pommen/Programmable_Load/README.md

# Programmable-Load

Programmable DC load 0-10 amps 0-40 volts
Based on STM32 "bluepill" mcu running STMduino core.

All schematics in KiĆAD
