pommen/Programmable_Load/HW/ControllerStage.kicad_pcb

## KiCad design HW/ControllerStage.kicad_pcb (2018-04-08)

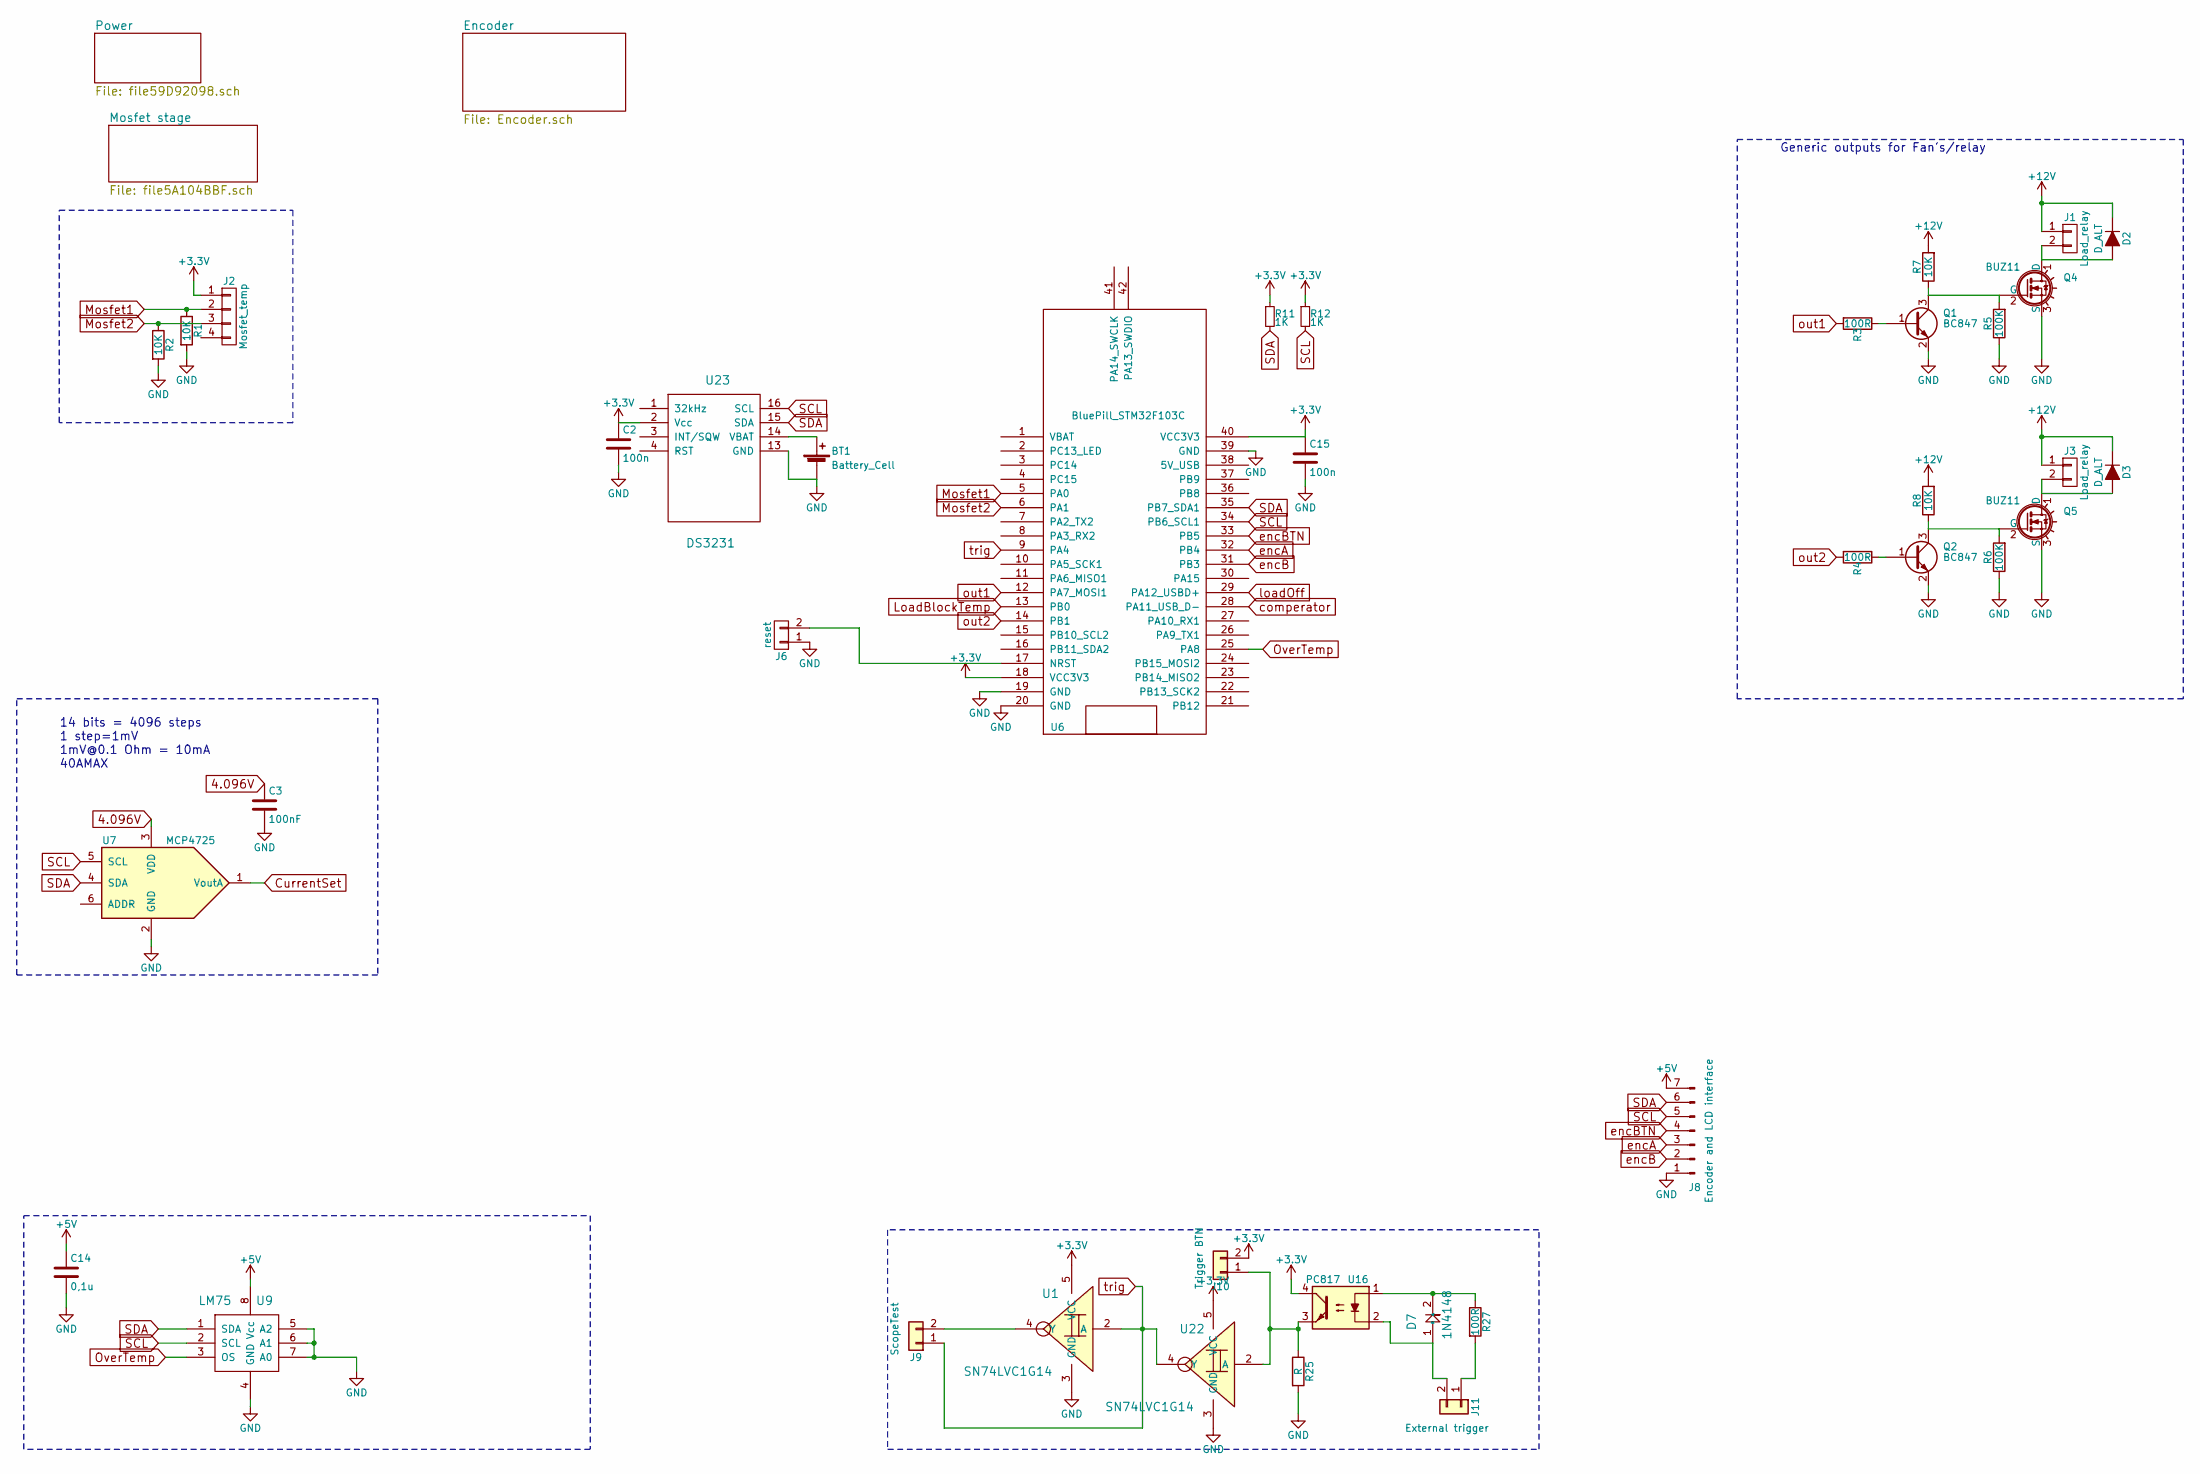
[picture p1: schematic ControllerStage.sch]

Parts:
BT1: Battery_Cell; Keystone_3008_1x2450-CoinCell
C2, C15: 100n; C_0805_HandSoldering
C3: 100nF; C_0805_HandSoldering
C14: 0,1u; C_0805_HandSoldering
D2, D3: D_ALT; D_MELF-RM10_Universal_Handsoldering
D7: 1N4148; D_DO-35_SOD27_P7.62mm_Horizontal
J1, J3: Load_relay; Socket_Strip_Straight_1x02_Pitch2.54mm
J2: Mosfet_temp; Socket_Strip_Straight_1x04_Pitch2.54mm
J6: reset; Pin_Header_Straight_1x02_Pitch2.54mm
J8: Encoder and LCD interface; Pin_Header_Straight_1x07_Pitch2.54mm
J9: ScopeTest; JUMPER_5MM
J10: Trigger BTN; JUMPER_5MM
J11: External trigger; JUMPER_5MM
Q1, Q2: BC847; SOT-23_Handsoldering
Q4, Q5: BUZ11; TO-220-3_Vertical
R1, R2, R7, R8: 10K; R_0805_HandSoldering
R3, R4, R27: 100R; R_0805_HandSoldering
R5, R6: 100K; R_0805_HandSoldering
R11, R12: 1K; R_0805_HandSoldering
R25: R; R_0805_HandSoldering
U1, U22: SN74LVC1G14; SOT-23-5_HandSoldering
U6: BluePill_STM32F103C
U7: MCP4725; TSOT-23-6_HandSoldering
U9: LM75; SO-8_5.3x6.2mm_Pitch1.27mm
U16: PC817; DIP-4_W7.62mm
U23: DS3231; SOIC-16W_7.5x10.3mm_Pitch1.27mm

Connections:
4.096V: C3.1, U7.3 (VDD); also elsewhere on the board
+3V3: C2.1, C15.1, J2.1, J10.2, R11.1, R12.1, U1.5 (VCC), U6.18 (VCC3V3), U6.40 (VCC3V3), U16.4, U22.5 (VCC), U23.2 (Vcc); also elsewhere on the board
+5V: C14.1, J8.7, U9.8 (Vcc); also elsewhere on the board
+12V: D2.1 (K), D3.1 (K), J1.1, J3.1, R7.2, R8.2; also elsewhere on the board
CurrentSet: U7.1 (VoutA); also elsewhere on the board
Earth: BT1.2 (-), C2.2, C3.2, C14.2, C15.2, J6.1, J8.1, Q1.2 (E), Q2.2 (E), Q4.3 (S), Q5.3 (S), R1.2, R2.2, R5.1, R6.1, R25.2, U1.3 (GND), U6.19 (GND), U6.20 (GND), U6.39 (GND), U7.2 (GND), U9.4 (GND), U9.5 (A2), U9.6 (A1), U9.7 (A0), U22.3 (GND), U23.11 (NC), U23.13 (GND); also elsewhere on the board
LoadBlockTemp: U6.13 (PB0); also elsewhere on the board
Mosfet1: J2.2, R1.1, U6.5 (PA0)
Mosfet2: J2.3, R2.1, U6.6 (PA1)
unnamed: BT1.1 (+), U23.14 (VBAT)
unnamed: D2.2 (A), J1.2, Q4.1 (D)
unnamed: D3.2 (A), J3.2, Q5.1 (D)
unnamed: D7.1 (A), J11.2, U16.2
unnamed: D7.2 (K), R27.1, U16.1
unnamed: J6.2, U6.17 (NRST)
unnamed: J9.2, U1.4 (Y)
unnamed: J10.1, R25.1, U16.3, U22.2 (A)
unnamed: J11.1, R27.2
unnamed: Q1.1 (B), R3.1
unnamed: Q1.3 (C), Q4.2 (G), R5.2, R7.1
unnamed: Q2.1 (B), R4.1
unnamed: Q2.3 (C), Q5.2 (G), R6.2, R8.1
OverTemp: U6.25 (PA8), U9.3 (OS)
SCL: J8.5, R12.2, U6.34 (PB6_SCL1), U7.5 (SCL), U9.2 (SCL), U23.16 (SCL); also elsewhere on the board
SDA: J8.6, R11.2, U6.35 (PB7_SDA1), U7.4 (SDA), U9.1 (SDA), U23.15 (SDA); also elsewhere on the board
comperator: U6.28 (PA11_USB_D-); also elsewhere on the board
encA: J8.3, U6.32 (PB4)
encB: J8.2, U6.31 (PB3)
encBTN: J8.4, U6.33 (PB5)
loadOff: U6.29 (PA12_USBD+); also elsewhere on the board
out1: R3.2, U6.12 (PA7_MOSI1)
out2: R4.2, U6.14 (PB1)
trig: J9.1, U1.2 (A), U6.9 (PA4), U22.4 (Y)

Notes on the sheet:
14 bits = 4096 steps 1 step=1mV 1mV@0.1 Ohm = 10mA 40AMAX
Generic outputs for Fan's/relay

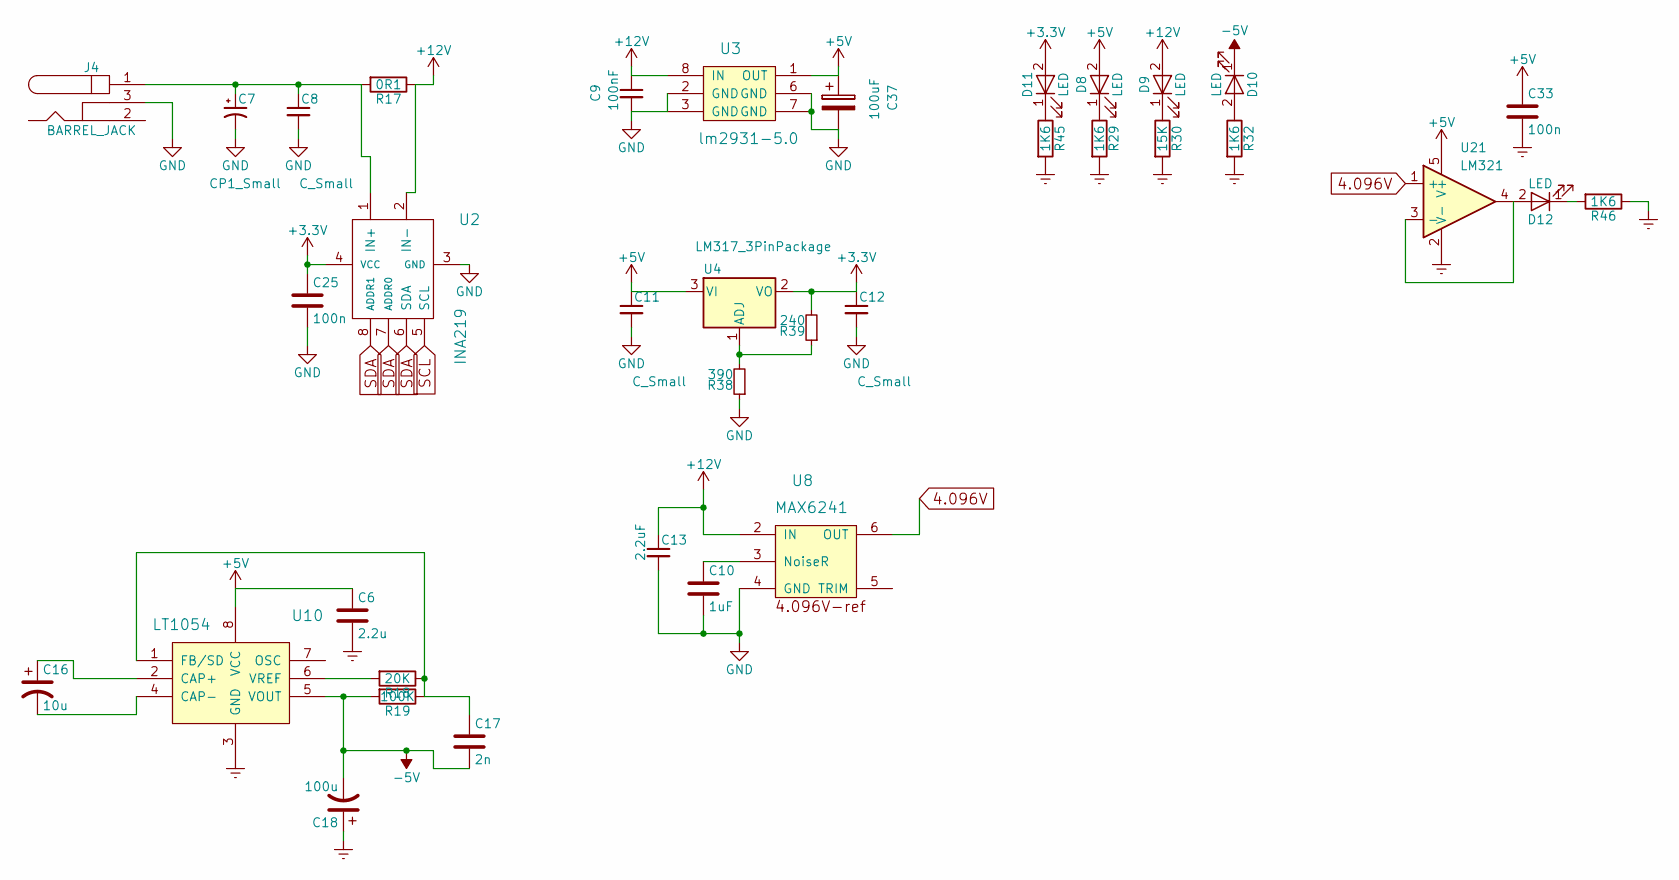
[picture p2: schematic file59D92098.sch]

Parts:
C6: 2.2u; C_0805_HandSoldering
C7: CP1_Small; CP_Tantalum_Case-C_EIA-6032-28_Hand
C8, C11, C12: C_Small; C_0805_HandSoldering
C9: 100nF; C_0805_HandSoldering
C10: 1uF; C_0805_HandSoldering
C13: 2.2uF; C_0805_HandSoldering
C16: 10u; CP_Tantalum_Case-B_EIA-3528-21_Hand
C17: 2n; C_0805_HandSoldering
C18: 100u; CP_Tantalum_Case-B_EIA-3528-21_Hand
C25, C33: 100n; C_0805_HandSoldering
C37: 100uF; CP_Radial_D6.3mm_P2.50mm
D8, D9, D10, D11, D12: LED; LED_0805_HandSoldering
J4: BARREL_JACK
R17: 0R1; R_1206_HandSoldering
R18: 20K; R_0805_HandSoldering
R19: 100K; R_0805_HandSoldering
R29, R32, R45, R46: 1K6; R_0805_HandSoldering
R30: 15K; R_0805_HandSoldering
R38: 390; R_0805_HandSoldering
R39: 240; R_0805_HandSoldering
U2: INA219; SOT-23-8_Handsoldering
U3: lm2931-5.0; SOIC-8_3.9x4.9mm_Pitch1.27mm
U4: LM317_3PinPackage; SOT-223-3_TabPin2
U8: MAX6241; SOIC-8_3.9x4.9mm_Pitch1.27mm
U10: LT1054; DIP-8_W7.62mm_LongPads
U21: LM321; SOT-23-5_HandSoldering

Connections:
4.096V: U8.6 (OUT), U21.1 (+); also elsewhere on the board
+3V3: C12.1, C25.1, D11.2 (A), R39.2, U2.4 (VCC), U4.2 (VO); also elsewhere on the board
+5V: C6.1, C11.1, C33.1, C37.1, D8.2 (A), U3.1 (OUT), U4.3 (VI), U10.8 (VCC), U21.5 (V+); also elsewhere on the board
+12V: C9.1, C13.1, D9.2 (A), R17.1, U2.2 (IN-), U3.8 (IN), U8.2 (IN); also elsewhere on the board
-5V: C17.2, C18.2, D10.1 (K), R19.2, U10.5 (VOUT); also elsewhere on the board
Earth: C6.2, C7.2, C8.2, C9.2, C10.2, C11.2, C12.2, C13.2, C18.1, C25.2, C33.2, C37.2, J4.3, R29.2, R30.2, R32.2, R38.1, R45.2, R46.1, U2.3 (GND), U3.2 (GND), U3.3 (GND), U3.6 (GND), U3.7 (GND), U8.4 (GND), U10.3 (GND), U21.2 (V-); also elsewhere on the board
unnamed: C7.1, C8.1, J4.1, R17.2, U2.1 (IN+)
unnamed: C10.1, U8.3 (NoiseR)
unnamed: C16.1, U10.2 (CAP+)
unnamed: C16.2, U10.4 (CAP-)
unnamed: C17.1, R18.1, R19.1, U10.1 (FB/SD)
unnamed: D8.1 (K), R29.1
unnamed: D9.1 (K), R30.1
unnamed: D10.2 (A), R32.1
unnamed: D11.1 (K), R45.1
unnamed: D12.1 (K), R46.2
unnamed: D12.2 (A), U21.3 (-), U21.4
unnamed: R18.2, U10.6 (VREF)
unnamed: R38.2, R39.1, U4.1 (ADJ)
SCL: U2.5 (SCL); also elsewhere on the board
SDA: U2.6 (SDA), U2.7 (ADDR0), U2.8 (ADDR1); also elsewhere on the board

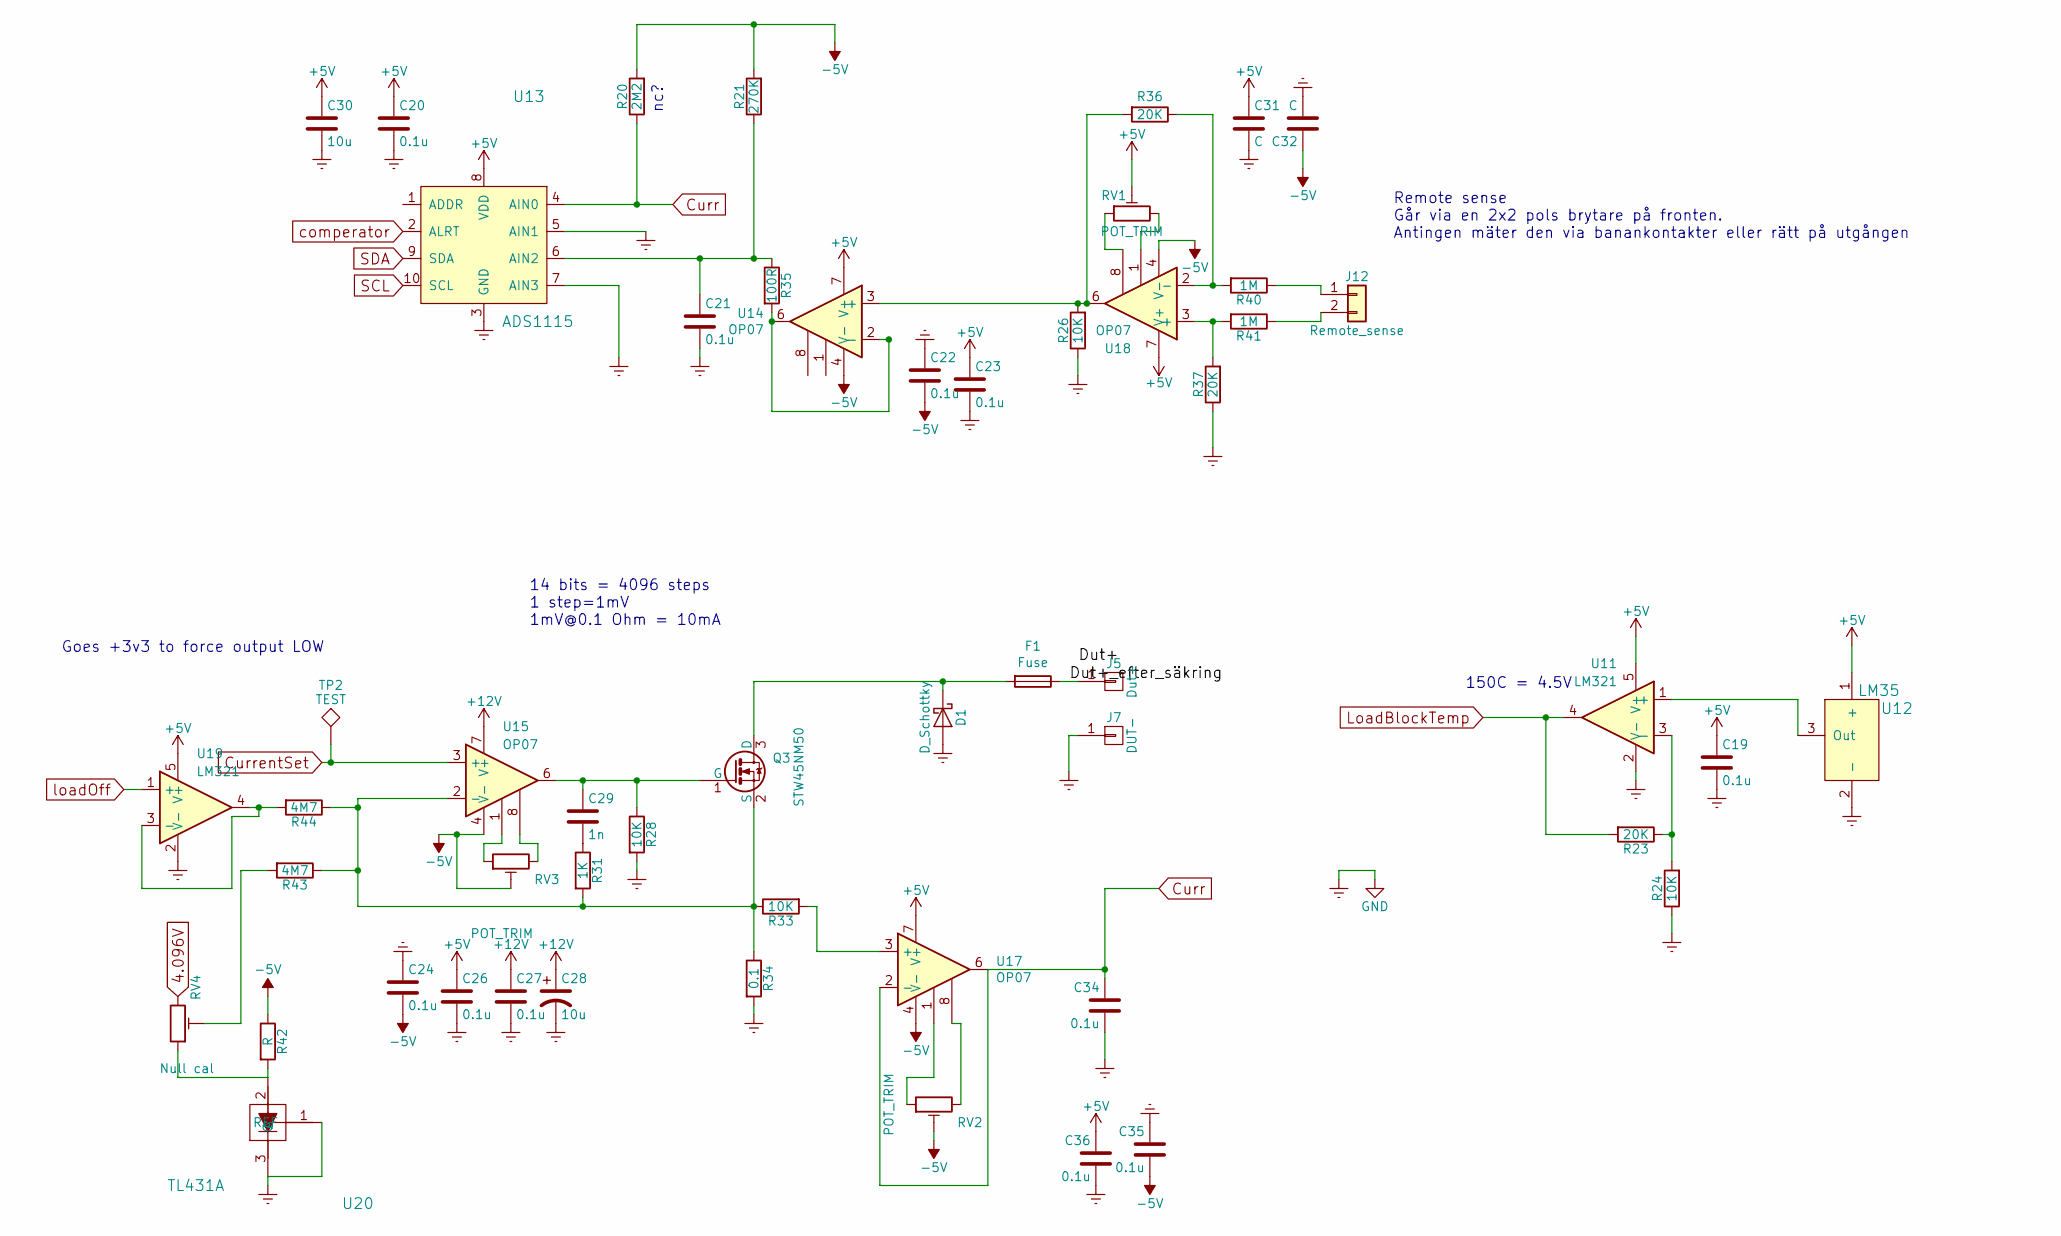
[picture p3: schematic file5A104BBF.sch, Programmable Load Mosfet stage]

Parts:
C19, C20, C21, C22, C23, C24, C26, C27, C34, C35, C36: 0.1u; C_0805_HandSoldering
C28: 10u; CP_Tantalum_Case-B_EIA-3528-21_Hand
C29: 1n; C_0805_HandSoldering
C30: 10u; C_0805_HandSoldering
C31, C32: C; C_0805_HandSoldering
D1: D_Schottky; D_SMB-SMC_Universal_Handsoldering
F1: Fuse; Fuseholder5x20_horiz_open_universal_Type-III
J5: Dut+; MountingHole_3.2mm_M3
J7: DUT-; MountingHole_3.2mm_M3
J12: Remote_sense; JUMPER_5MM
Q3: STW45NM50; TO-247_TO-3P_Vertical
R20: 2M2; R_0805_HandSoldering
R21: 270K; R_0805_HandSoldering
R23, R36, R37: 20K; R_0805_HandSoldering
R24, R26, R28, R33: 10K; R_0805_HandSoldering
R31: 1K; R_0805_HandSoldering
R34: 0.1; R_Axial_DIN0516_L15.5mm_D5.0mm_P20.32mm_Horizontal
R35: 100R; R_0805_HandSoldering
R40, R41: 1M; R_0805_HandSoldering
R42: R; R_0805_HandSoldering
R43, R44: 4M7; R_0805_HandSoldering
RV1, RV2, RV3: POT_TRIM; Potentiometer_Trimmer_ACP_CA9h3.8_Vertical_Px3.8mm_Py5.0mm
RV4: Null cal; Potentiometer_Trimmer_ACP_CA9h3.8_Vertical_Px3.8mm_Py5.0mm
TP2: TEST; Pin_Header_Angled_1x01_Pitch1.00mm
U11, U19: LM321; SOT-23-5_HandSoldering
U12: LM35; TO-220-3_Vertical
U13: ADS1115; ADS1115-Breakout
U14, U15, U17, U18: OP07; DIP-8_W7.62mm_Socket_LongPads
U20: TL431A; TO-92_Inline_Wide

Connections:
4.096V: RV4.3; also elsewhere on the board
+5V: C19.1, C20.1, C23.1, C26.1, C30.1, C31.1, C36.1, RV1.2, U11.5 (V+), U12.1 (+), U13.8 (VDD), U14.7 (V+), U17.7 (V+), U18.7 (V+), U19.5 (V+); also elsewhere on the board
+12V: C27.1, C28.1, U15.7 (V+); also elsewhere on the board
-5V: C22.2, C24.2, C32.1, C35.2, R20.2, R21.2, R42.1, RV2.2, RV3.2, U14.4 (V-), U15.4 (V-), U17.4 (V-), U18.4 (V-); also elsewhere on the board
/Mosfet stage/Dut+_efter_säkring: F1.1, J5.1
Curr: C34.1, R20.1, U13.4 (AIN0), U17.2 (-), U17.6
CurrentSet: TP2.1, U15.3 (+); also elsewhere on the board
Earth: C19.2, C20.2, C21.2, C22.1, C23.2, C24.1, C26.2, C27.2, C28.2, C30.2, C31.2, C32.2, C34.2, C35.1, C36.2, D1.2 (A), J7.1, R24.1, R26.1, R28.2, R34.2, R37.1, U11.2 (V-), U12.2 (-), U13.3 (GND), U13.5 (AIN1), U13.7 (AIN3), U19.2 (V-), U20.1 (REF), U20.3 (C); also elsewhere on the board
LoadBlockTemp: R23.2, U11.4; also elsewhere on the board
unnamed: C21.1, R21.1, R35.1, U13.6 (AIN2)
unnamed: C29.1, Q3.1 (G), R28.1, U15.6
unnamed: C29.2, R31.1
unnamed: D1.1 (K), F1.2, Q3.3 (D)
unnamed: J12.1, R40.1
unnamed: J12.2, R41.1
unnamed: Q3.2 (S), R31.2, R33.1, R34.1, R43.1, R44.1, U15.2 (-)
unnamed: R23.1, R24.2, U11.3 (-)
unnamed: R26.2, R36.2, U14.3 (+), U18.6
unnamed: R33.2, U17.3 (+)
unnamed: R35.2, U14.2 (-), U14.6
unnamed: R36.1, R40.2, U18.2 (-)
unnamed: R37.2, R41.2, U18.3 (+)
unnamed: R42.2, RV4.1, U20.2 (A)
unnamed: R43.2, RV4.2
unnamed: R44.2, U19.3 (-), U19.4
unnamed: RV1.1, U18.8
unnamed: RV1.3, U18.1
unnamed: RV2.1, U17.1
unnamed: RV2.3, U17.8
unnamed: RV3.1, U15.1
unnamed: RV3.3, U15.8
unnamed: U11.1 (+), U12.3 (Out)
SCL: U13.10 (SCL); also elsewhere on the board
SDA: U13.9 (SDA); also elsewhere on the board
comperator: U13.2 (ALRT); also elsewhere on the board
loadOff: U19.1 (+); also elsewhere on the board

Notes on the sheet:
150C = 4.5V
14 bits = 4096 steps 1 step=1mV 1mV@0.1 Ohm = 10mA
Remote sense Går via en 2x2 pols brytare på fronten. Antingen mäter den via banankontakter eller rätt på utgången
nc?
Goes +3v3 to force output LOW

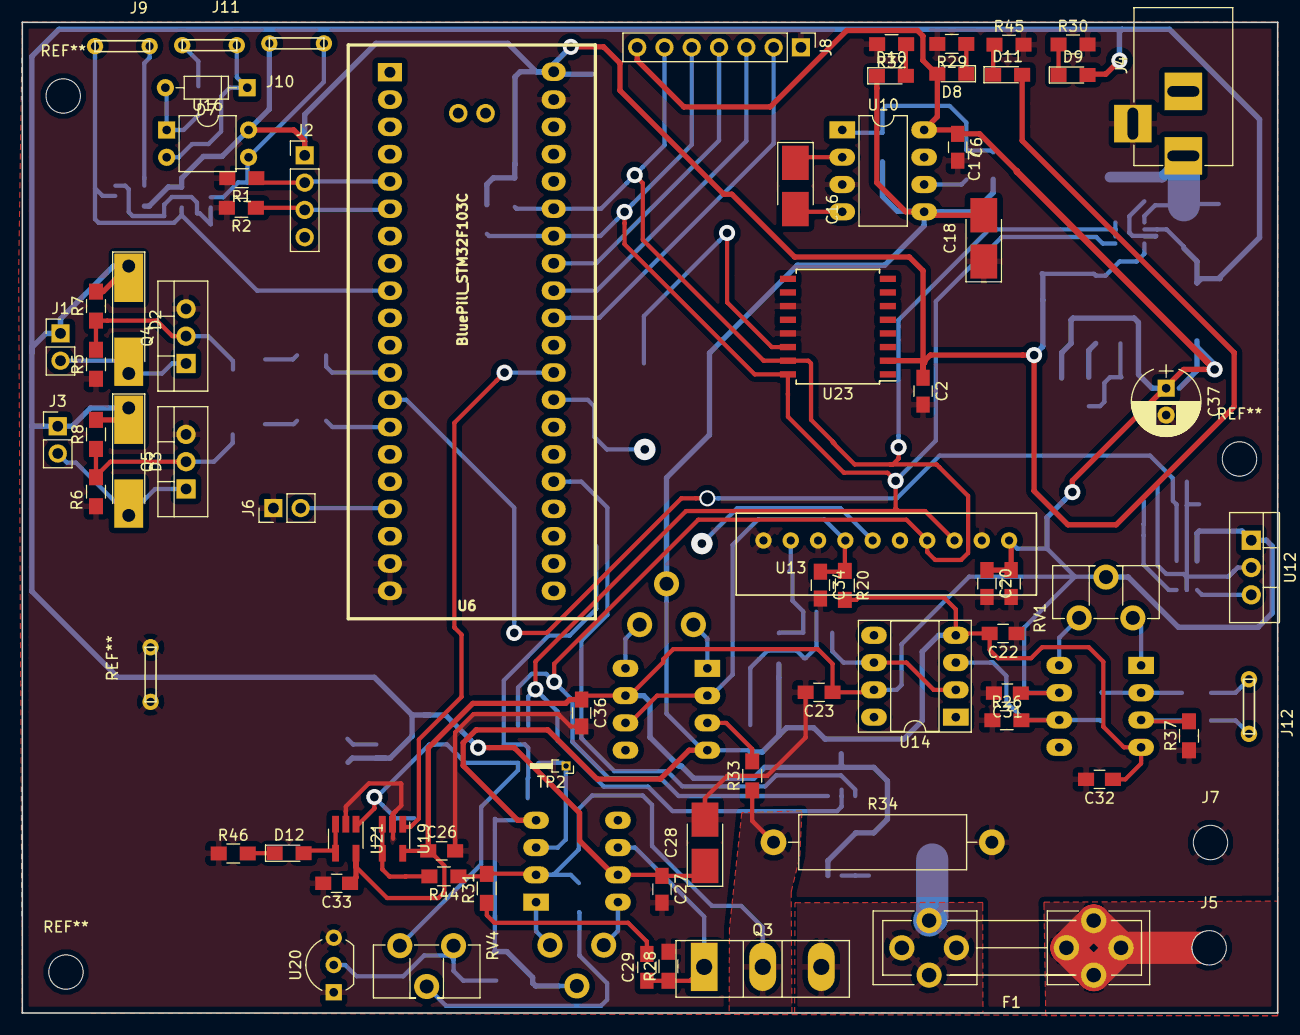
[picture p4: board ControllerStage.kicad_pcb from above]

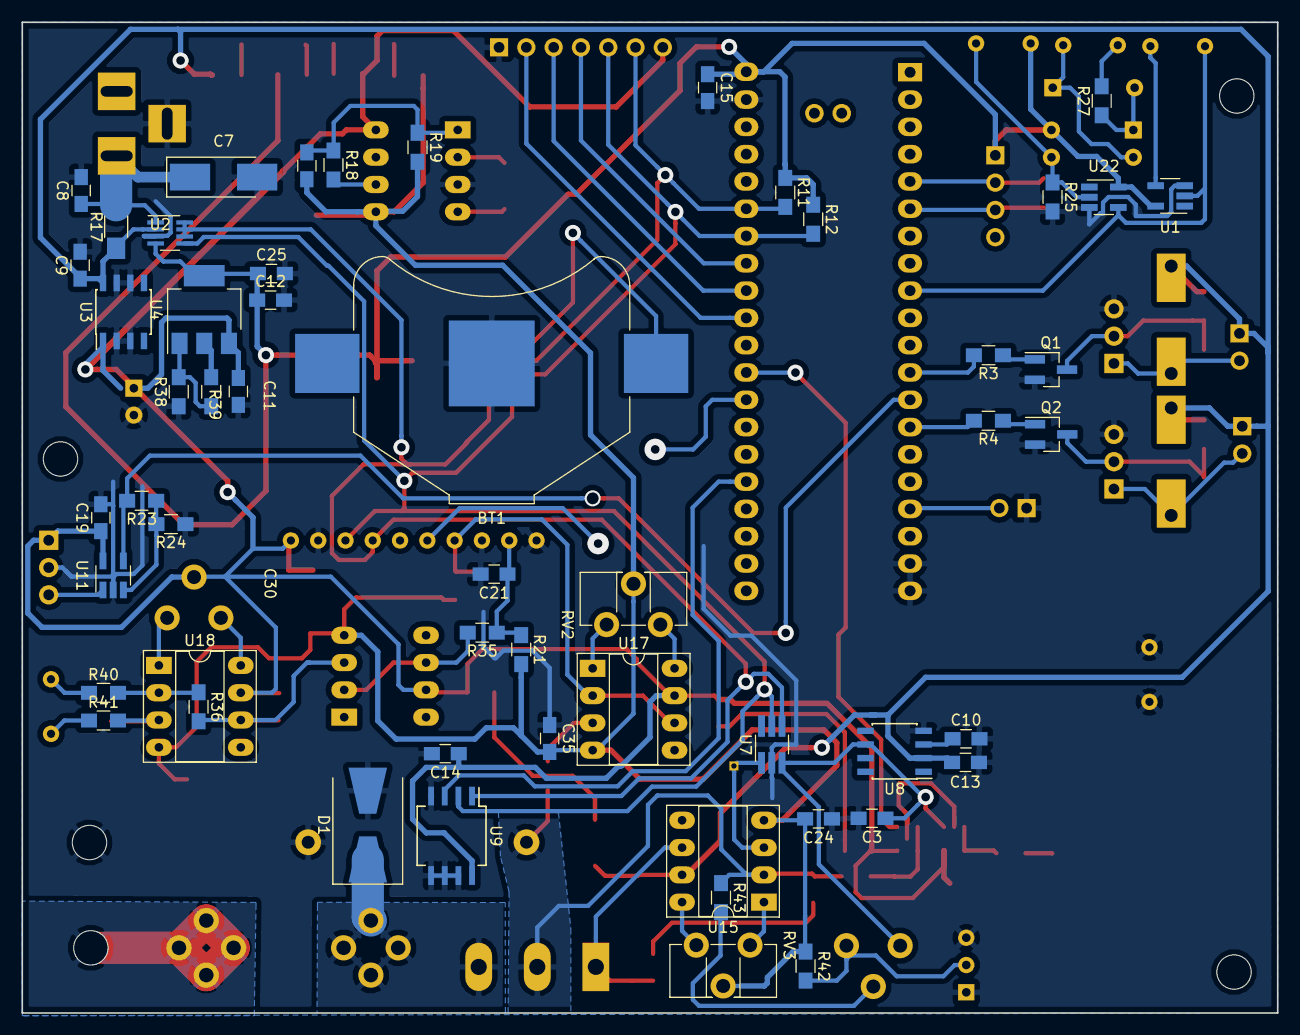
[picture p5: board ControllerStage.kicad_pcb from below]

Board: 2 copper layers, 116.8 x 92.2 mm, 128 parts (54 on the bottom side), 72 nets.
