pommen/Programmable_Load/HW/MosfetStage.kicad_pcb

## KiCad design HW/MosfetStage.kicad_pcb (2018-04-08)

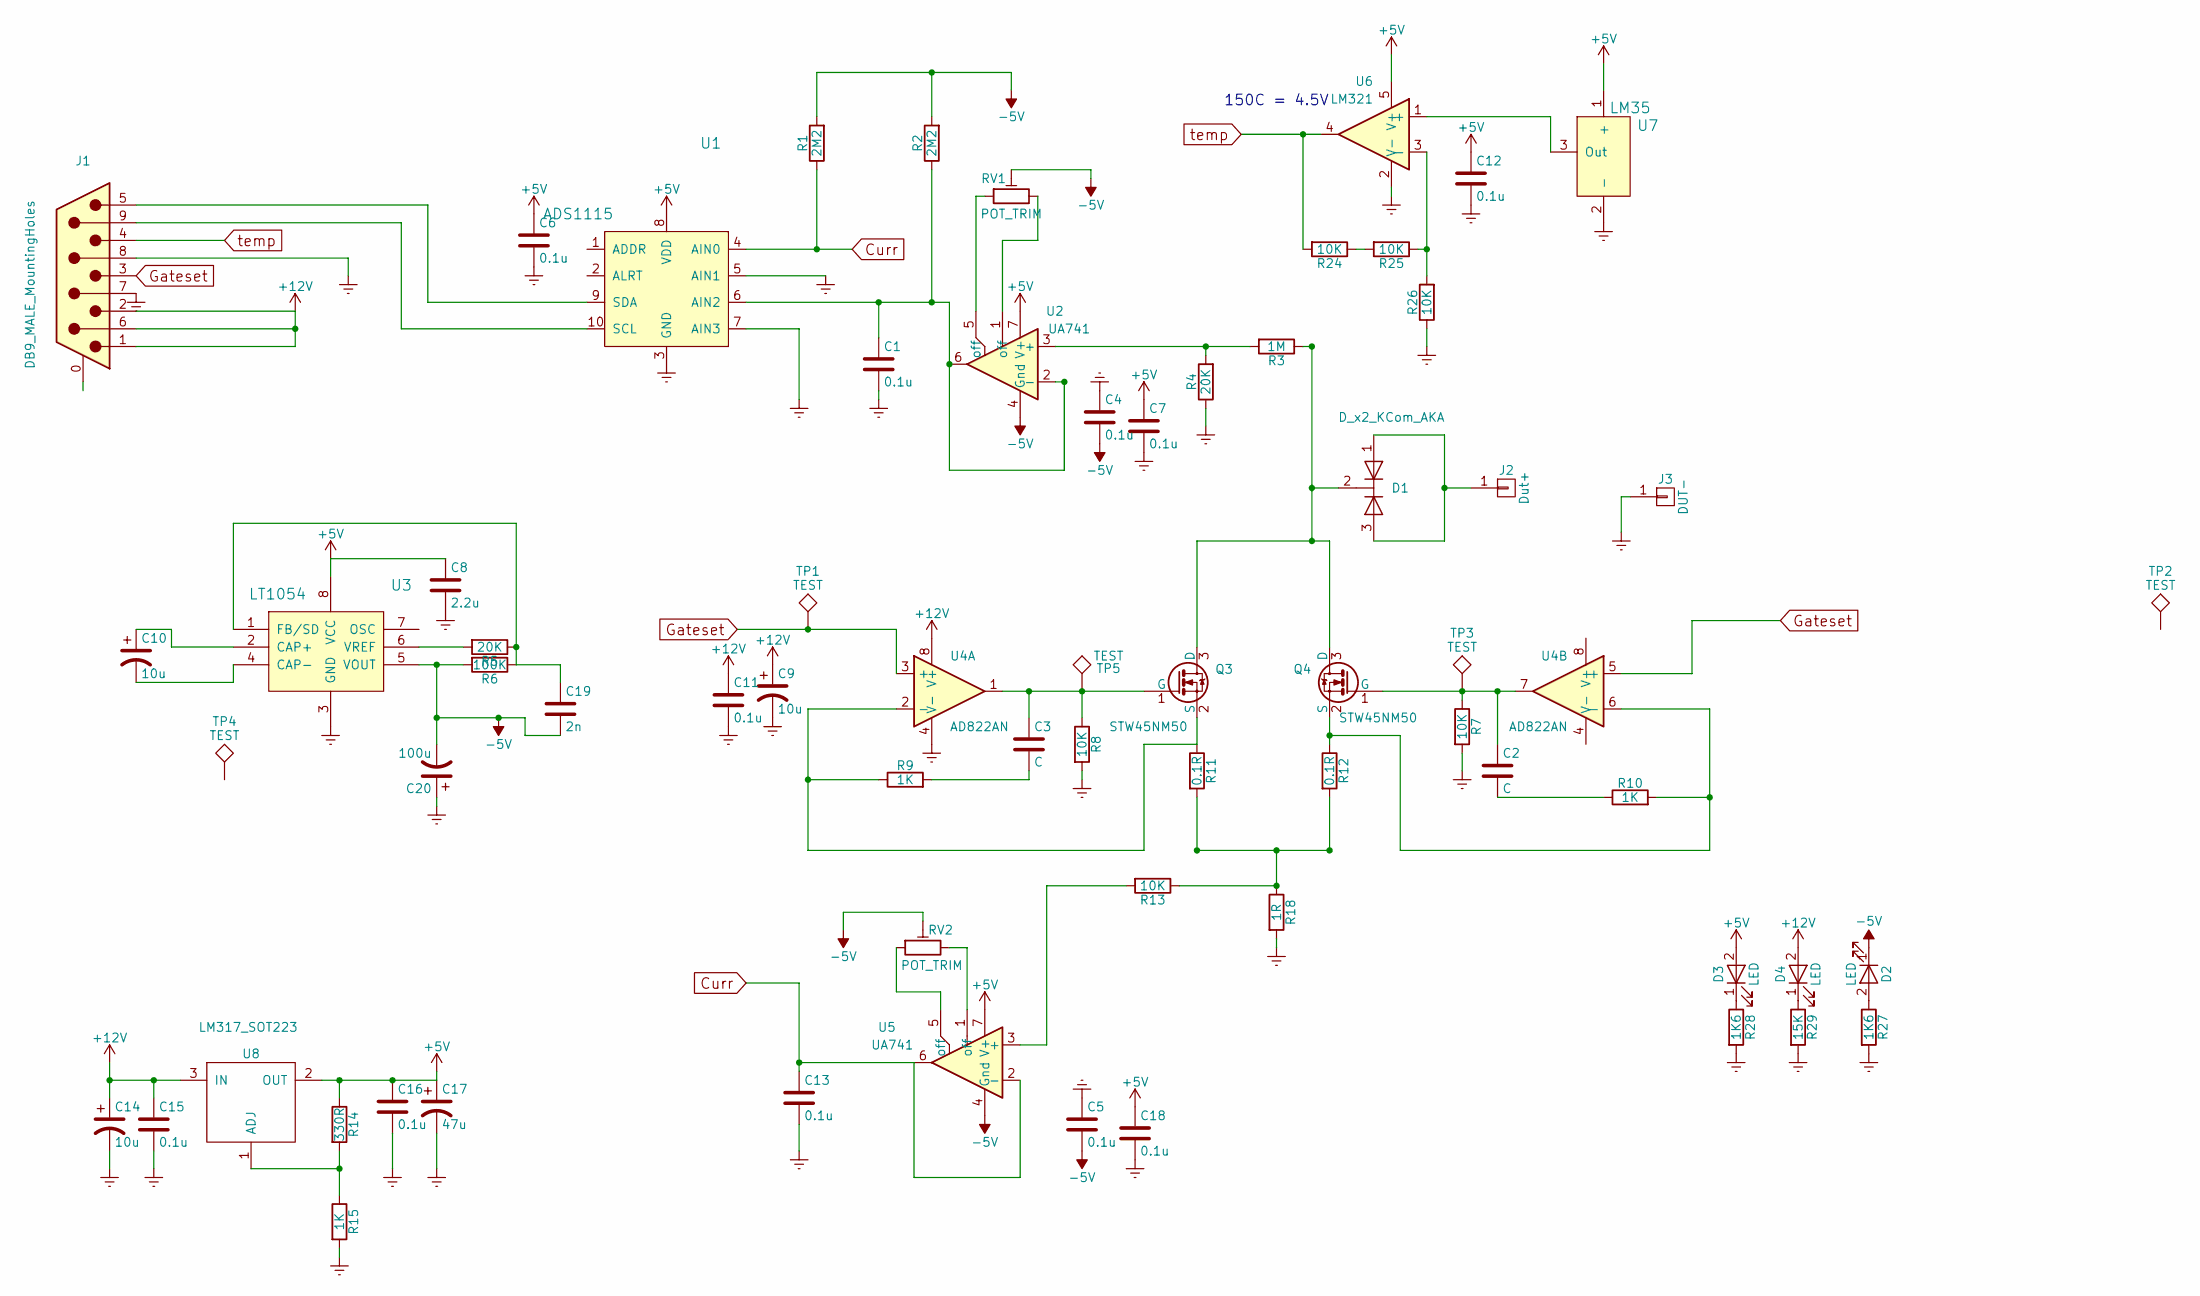
[picture p6: schematic MosfetStage.sch, Programmable Load Mosfet stage]

Parts:
C1, C4, C5, C6, C7, C11, C12, C13, C15, C18: 0.1u; C_0805_HandSoldering
C2, C3: C; C_0805_HandSoldering
C8: 2.2u; C_0805_HandSoldering
C9, C10: 10u; CP_Tantalum_Case-B_EIA-3528-21_Hand
C14: 10u; CP_Radial_D8.0mm_P3.50mm
C16: 0.1u; CP_Tantalum_Case-T_EIA-3528-12_Hand
C17: 47u; CP_Tantalum_Case-T_EIA-3528-12_Hand
C19: 2n; C_0805_HandSoldering
C20: 100u; CP_Tantalum_Case-B_EIA-3528-21_Hand
D1: D_x2_KCom_AKA; TO-263-2
D2, D3, D4: LED; LED_0805_HandSoldering
J1: DB9_MALE_MountingHoles; DB9MC
J2: Dut+; MountingHole_3.2mm_M3
J3: DUT-; MountingHole_3.2mm_M3
Q3, Q4: STW45NM50; TO-247_TO-3P_Horizontal
R1, R2: 2M2; R_0805_HandSoldering
R3: 1M; R_0805_HandSoldering
R4, R5: 20K; R_0805_HandSoldering
R6: 100K; R_0805_HandSoldering
R7, R8, R13, R24, R25, R26: 10K; R_0805_HandSoldering
R9, R10, R15: 1K; R_0805_HandSoldering
R11, R12: 0.1R; R_Axial_Power_L25.0mm_W9.0mm_P27.94mm
R14: 330R; R_0805_HandSoldering
R18: 1R; R_Axial_DIN0516_L15.5mm_D5.0mm_P20.32mm_Horizontal
R27, R28: 1K6; R_0805_HandSoldering
R29: 15K; R_0805_HandSoldering
RV1, RV2: POT_TRIM; Potentiometer_Trimmer_ACP_CA9h3.8_Vertical_Px3.8mm_Py5.0mm
TP1, TP2, TP3, TP4, TP5: TEST; Measurement_Point_Round-TH_Big
U1: ADS1115; ADS1115-Breakout
U2, U5: UA741; DIP-8_W7.62mm_Socket_LongPads
U3: LT1054; DIP-8_W7.62mm_LongPads
U4: AD822AN; DIP-8_W7.62mm_LongPads
U6: LM321; SOT-23-5
U7: LM35; TO-220_Vertical
U8: LM317_SOT223; SOT-223

Connections:
+5V: C6.1, C7.1, C8.1, C12.1, C16.1, C17.1, C18.1, D3.2 (A), R14.1, U1.8 (VDD), U2.7 (V+), U3.8 (VCC), U5.7 (V+), U6.5 (V+), U7.1 (+), U8.2 (OUT)
+12V: C9.1, C11.1, C14.1, C15.1, D4.2 (A), J1.1, J1.2, J1.6, U4.8 (V+), U8.3 (IN)
-5V: C4.2, C5.2, C19.2, C20.2, D2.1 (K), R1.2, R2.2, R6.2, RV1.2, RV2.2, U2.4 (Gnd), U3.5 (VOUT), U5.4 (Gnd)
Curr: C13.1, R1.1, U1.4 (AIN0), U5.2 (-), U5.6
Earth: C1.2, C4.1, C5.1, C6.2, C7.2, C8.2, C9.2, C11.2, C12.2, C13.2, C14.2, C15.2, C16.2, C17.2, C18.2, C20.1, J1.7, J1.8, J3.1, R4.1, R7.2, R8.2, R15.2, R18.2, R26.1, R27.2, R28.2, R29.2, U1.3 (GND), U1.5 (AIN1), U1.7 (AIN3), U3.3 (GND), U4.4 (V-), U6.2 (V-), U7.2 (-)
Gateset: J1.3, TP1.1, U4.3 (+), U4.5 (+)
unnamed: C1.1, R2.1, U1.6 (AIN2), U2.2 (-), U2.6
unnamed: C2.1, Q4.1 (G), R7.1, TP3.1, U4.7
unnamed: C2.2, R10.1
unnamed: C3.1, Q3.1 (G), R8.1, TP5.1, U4.1
unnamed: C3.2, R9.2
unnamed: C10.1, U3.2 (CAP+)
unnamed: C10.2, U3.4 (CAP-)
unnamed: C19.1, R5.1, R6.1, U3.1 (FB/SD)
unnamed: D1.1 (A), D1.3 (A), J2.1
unnamed: D1.2 (K), Q3.3 (D), Q4.3 (D), R3.1
unnamed: D2.2 (A), R27.1
unnamed: D3.1 (K), R28.1
unnamed: D4.1 (K), R29.1
unnamed: J1.5, U1.9 (SDA)
unnamed: J1.9, U1.10 (SCL)
unnamed: Q3.2 (S), R9.1, R11.1, U4.2 (-)
unnamed: Q4.2 (S), R10.2, R12.1, U4.6 (-)
unnamed: R3.2, R4.2, U2.3 (+)
unnamed: R5.2, U3.6 (VREF)
unnamed: R11.2, R12.2, R13.1, R18.1
unnamed: R13.2, U5.3 (+)
unnamed: R14.2, R15.1, U8.1 (ADJ)
unnamed: R24.1, R25.2
unnamed: R25.1, R26.2, U6.3 (-)
unnamed: RV1.1, U2.5 (off)
unnamed: RV1.3, U2.1 (off)
unnamed: RV2.1, U5.5 (off)
unnamed: RV2.3, U5.1 (off)
unnamed: U6.1 (+), U7.3 (Out)
temp: J1.4, R24.2, U6.4

Notes on the sheet:
150C = 4.5V
