pommen/Programmable_Load/HW/MosfetStage.kicad_pcb

## KiCad design HW/MosfetStage.kicad_pcb (continued)

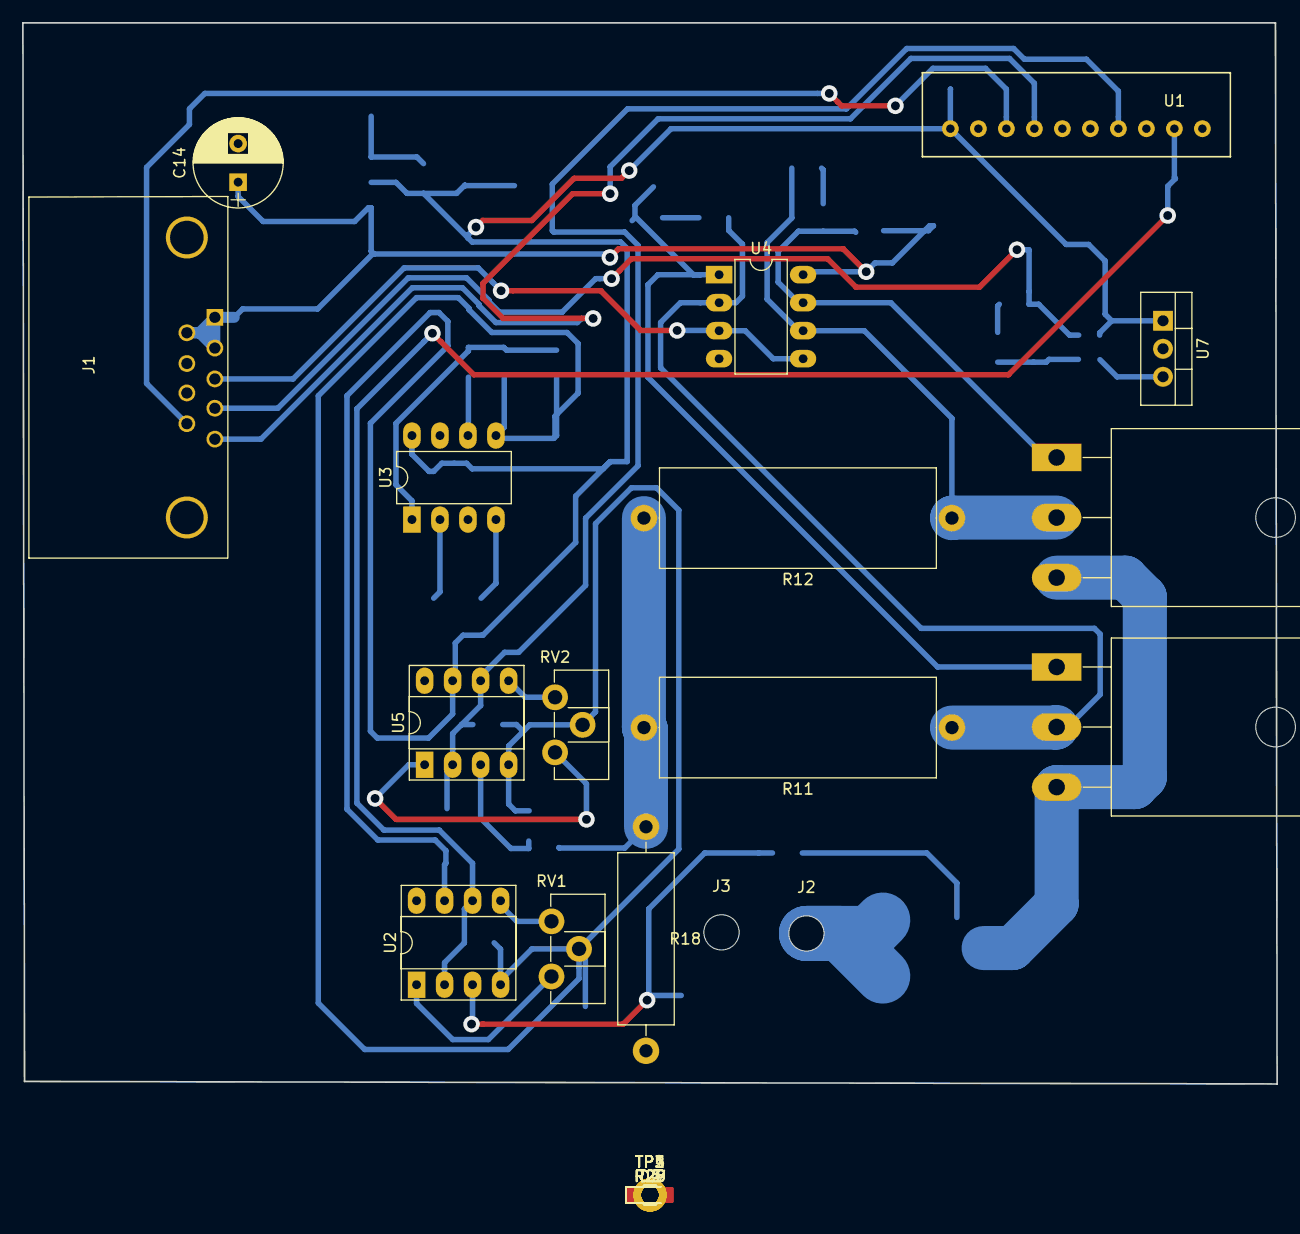
[picture p7: board MosfetStage.kicad_pcb from above]

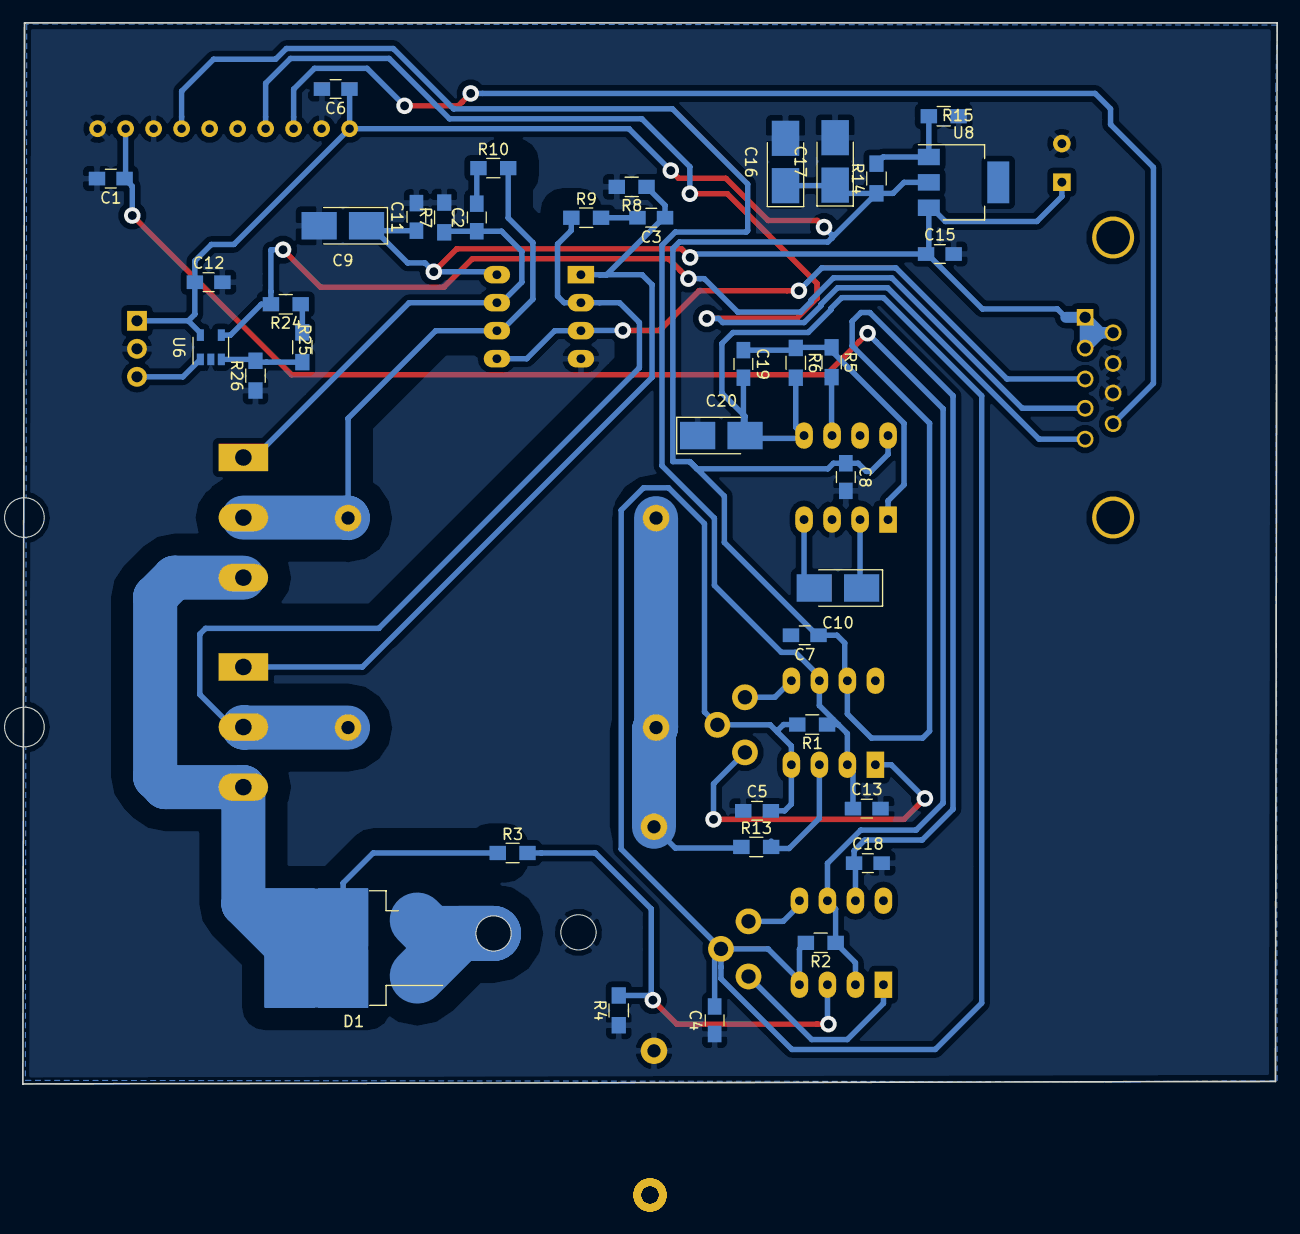
[picture p8: board MosfetStage.kicad_pcb from below]

Board: 2 copper layers, 113.8 x 96.2 mm, 66 parts (38 on the bottom side), 36 nets.
