pommen/Programmable_Load/(commit log)

2017-09-02 Fet drive board
    [MosfetStage.kicad_pcb, MosfetStage.sch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]
2017-09-23 Added pwm for fan
2017-09-30 Logic for enable load switch
2018-04-02 Schematic and layout
    [ControllerStage.kicad_pcb, ControllerStage.sch, Encoder.sch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]
2018-04-14 fan control and bug fixes
    [_saved_ControllerStage.sch]
2018-04-15 söndags
    [ControllerStage.sch, Encoder.sch, _saved_ControllerStage.sch, file59D92098.sch, file5A104BBF.sch]
2018-04-19 cleanup - getting ready for v0.2
    [ControllerStage.sch, Encoder.sch, file59D92098.sch, file5A104BBF.sch]
2018-04-21 friday layout
    [MCU.sch, file5AD8A8B3.sch, file5AD8A8C6.sch, v2.kicad_pcb, v2.sch]
2018-04-21 i2c pots for calibrating
    [MCU.sch, file5AD8A8B3.sch, file5AD8A8C6.sch, v2.kicad_pcb, v2.sch]
2018-04-22 v2 done
    [MCU.sch, file5AD8A8B3.sch, file5AD8A8C6.sch, v2.kicad_pcb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]
2018-04-27 press "b"
    [v2.kicad_pcb]
2018-05-05 Before starting saturday
    [MCU.sch, file5AD8A8B3.sch, file5AD8A8C6.sch, v2.kicad_pcb, v2.sch]
2018-05-13 Sunday ca, mneu and buttons
2018-05-15 Voltage cal DONE!
2018-06-22 soon done
    [ControllerStage.kicad_pcb, ControllerStage.sch, Encoder.sch, MCU.sch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]
